Jed0vcela/easy-linear-power-supply/easy-linear-power-supply SMD/EAGLE files/linear supply3_smd.brd

## EAGLE design easy-linear-power-supply SMD/EAGLE files/linear supply3_smd.brd (2024-04-13)

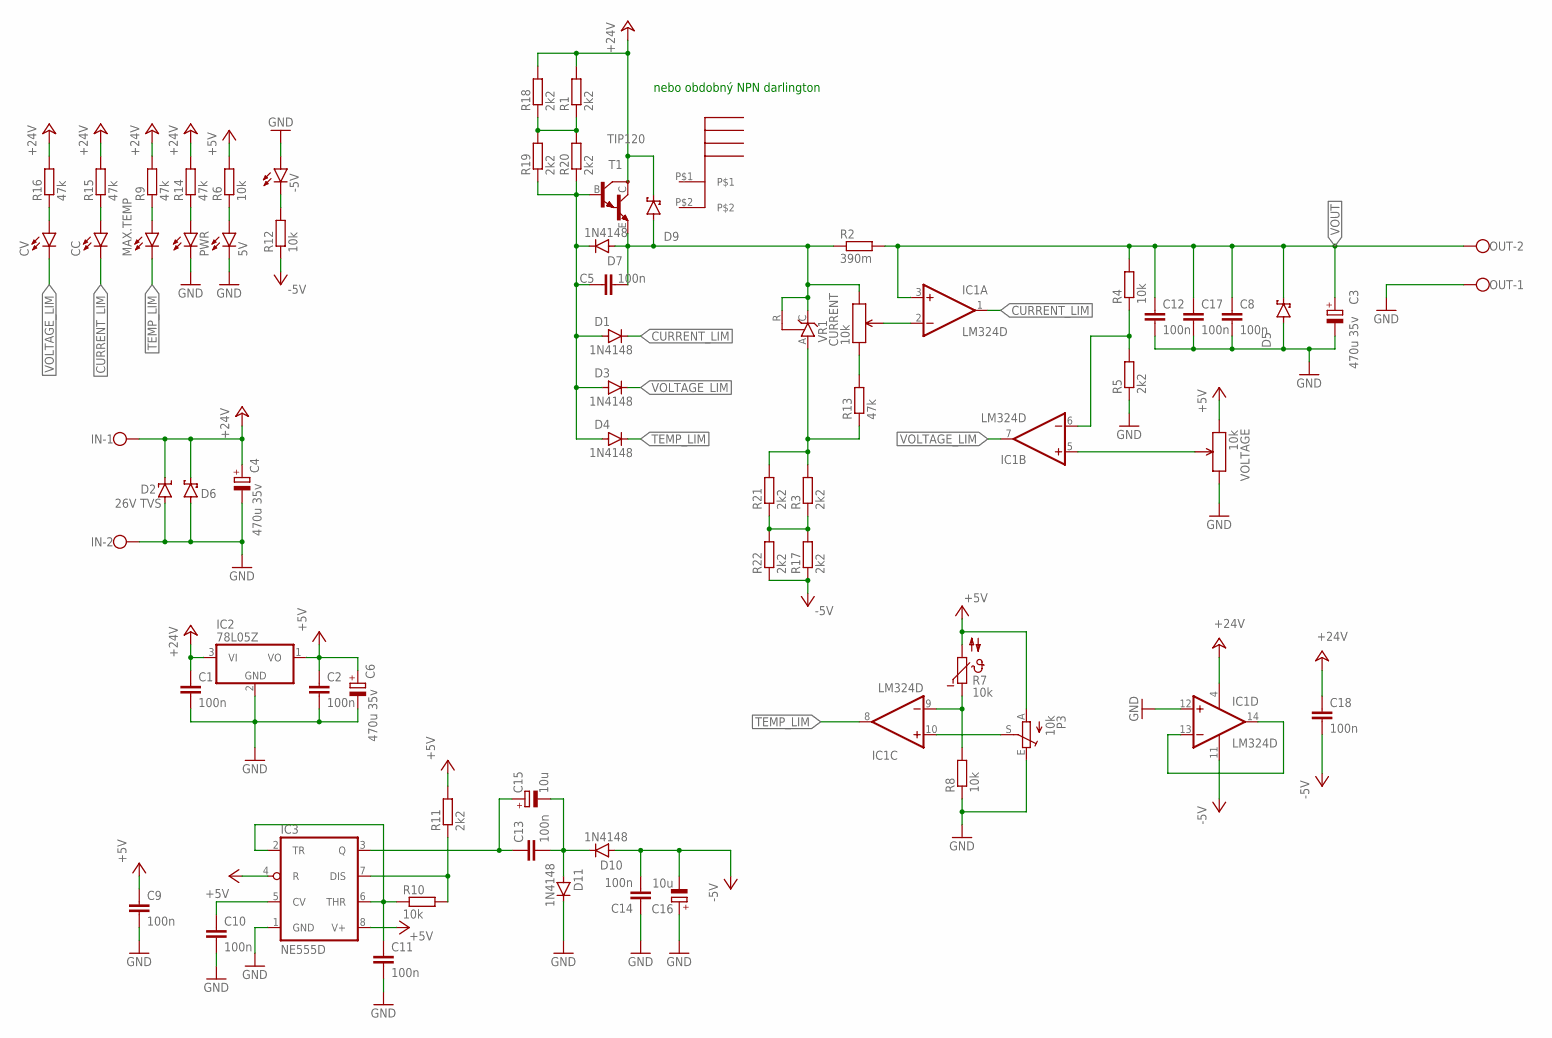
[picture p3: schematic linear supply3_smd.sch]

Parts:
5V: LEDCHIP-LED0805; CHIP-LED0805
-5V: LEDCHIP-LED0805; CHIP-LED0805
C1, C2, C5, C9, C10, C11, C13, C14, C18: 100n; C0805
C3, C4, C6: 470u 35v; E5-10,5
C8: 100n; C050-050X075
C12, C17: 100n; C1206
C15, C16: 10u; E2,5-6
CC: LEDCHIP-LED0805; CHIP-LED0805
CURRENT: 10k; THRU_PCW_POT
CV: LEDCHIP-LED0805; CHIP-LED0805
D1, D3, D4, D7, D10, D11: 1N4148; SOD80C
D2: 26V TVS; SMBJ
D5, D6, D9: SCHOTTKY-DIODESMC; SMC
IC1: LM324D; SO14
IC2: 78L05Z; TO92
IC3: NE555D; SO08
IN: W237-102
MAX.TEMP: LEDCHIP-LED0805; CHIP-LED0805
OUT: W237-102
P3: 10k; CA6V
PWR: LEDCHIP-LED0805; CHIP-LED0805
R1, R3, R5, R11, R17, R18, R19, R20, R21, R22: 2k2; R0805
R2: 390m; 0411/12
R4, R6, R8, R10, R12: 10k; R0805
R7: 10k; P642
R9, R13, R14, R15, R16: 47k; R0805
T1: TIP120; SOT93
U$1: RAD-DY-KY/3; RAD-DY-KY/3HEATSINK
VOLTAGE: 10k; THRU_PCW_POT
VR1: TL431CLP; TO92-CLP

Connections:
+5V: C2.1, C6.+, C9.1, IC2.1 (VO), IC3.4 (R), IC3.8 (V+), P3.A, R6.2, R7.2, R11.2, VOLTAGE.P$1 (1)
+24V: C1.1, C4.+, C18.1, D2.C, D6.C, D9.C, IC1.4 (V+), IC2.3 (VI), IN.1, R1.2, R9.2, R14.2, R15.2, R16.2, R18.2, T1.C
-5V: C14.2, C16.-, C18.2, D10.A, IC1.11 (V-), R12.1, R17.1, R22.1
CURRENT_LIM: CC.C, D1.C, IC1.1 (OUT)
GND: 5V.C, -5V.A, C1.2, C2.2, C3.-, C4.-, C6.-, C8.2, C9.2, C10.2, C11.2, C12.2, C14.1, C16.+, C17.2, D2.A, D5.A, D6.A, D11.C, IC1.12 (+IN), IC2.2 (GND), IC3.1 (GND), IN.2, OUT.1, P3.E, PWR.C, R5.1, R8.1, VOLTAGE.P$3 (3)
MAX: R3.2, R13.1, R21.2, VR1.A
MIN: C5.2, CURRENT.P$3 (3), D7.A, D9.A, R2.1, T1.E, VR1.C, VR1.R
unnamed: C5.1, D1.A, D3.A, D4.A, D7.C, R19.1, R20.1, T1.B
unnamed: PWR.A, R14.1
unnamed: C11.1, IC3.2 (TR), IC3.6 (THR), R10.1
unnamed: IC1.9 (-IN), R7.1, R8.2
unnamed: IC1.6 (-IN), R4.1, R5.2
unnamed: 5V.A, R6.1
unnamed: IC1.5 (+IN), VOLTAGE.P$2 (2)
unnamed: IC1.10 (+IN), P3.S
unnamed: CURRENT.P$2 (2), IC1.2 (-IN)
unnamed: MAX.TEMP.A, R9.1
unnamed: IC1.13 (-IN), IC1.14 (OUT)
unnamed: IC3.7 (DIS), R10.2, R11.1
unnamed: C13.1, C15.+, IC3.3 (Q)
unnamed: C10.1, IC3.5 (CV)
unnamed: C13.2, C15.-, D10.C, D11.A
unnamed: -5V.C, R12.2
unnamed: CURRENT.P$1 (1), R13.2
unnamed: CC.A, R15.1
unnamed: CV.A, R16.1
unnamed: R1.1, R18.1, R19.2, R20.2
unnamed: R3.1, R17.2, R21.1, R22.2
TEMP_LIM: D4.C, IC1.8 (OUT), MAX.TEMP.C
VOLTAGE_LIM: CV.C, D3.C, IC1.7 (OUT)
VOUT: C3.+, C8.1, C12.1, C17.1, D5.C, IC1.3 (+IN), OUT.2, R2.2, R4.2

Notes on the sheet:
nebo obdobný NPN darlington

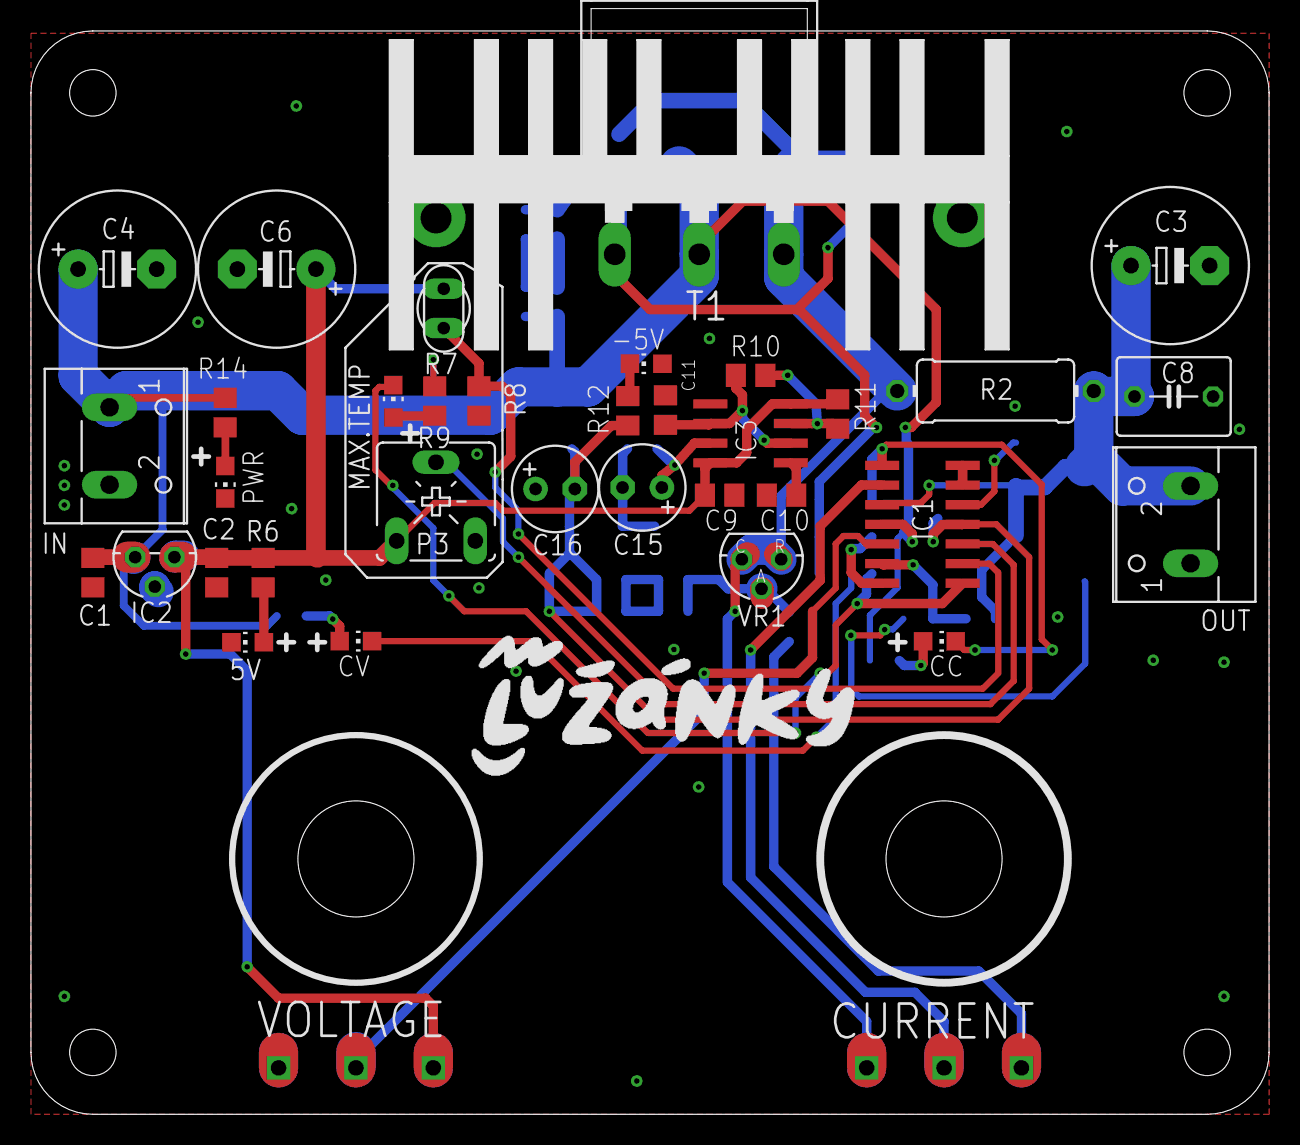
[picture p4: board linear supply3_smd.brd from above]

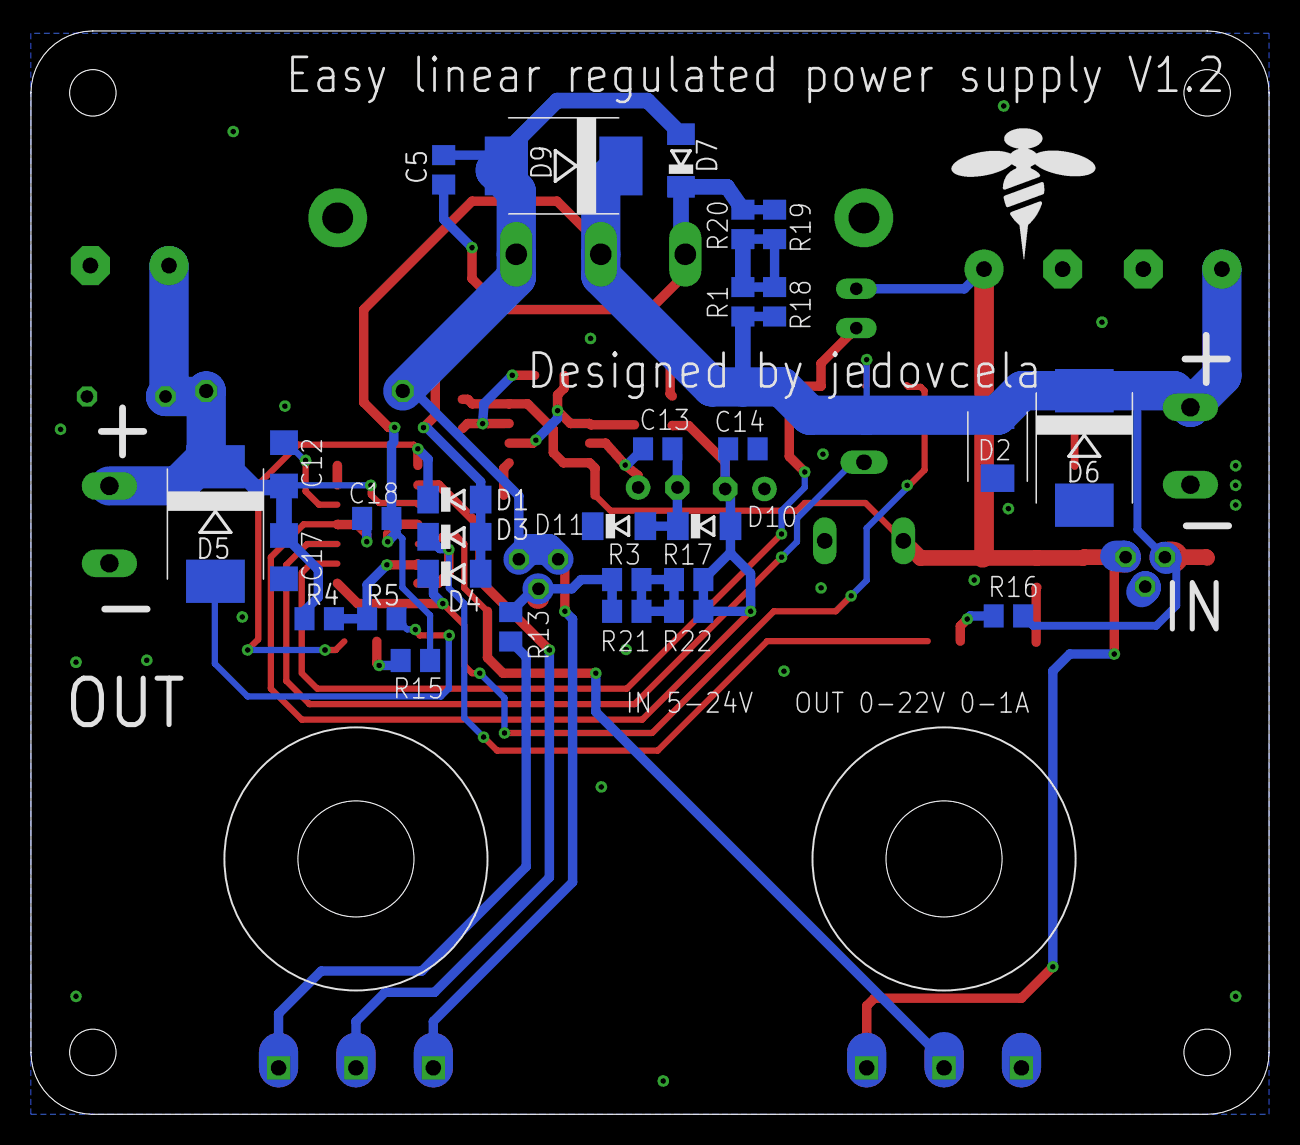
[picture p5: board linear supply3_smd.brd from below]

Board: 2 copper layers, 80.0 x 70.0 mm, 66 parts (31 on the bottom side), 31 nets.
