Jed0vcela/easy-linear-power-supply/easy-linear-power-supply THT/EAGLE file/linear supply2.brd

## EAGLE design easy-linear-power-supply THT/EAGLE file/linear supply2.brd (2024-04-13)

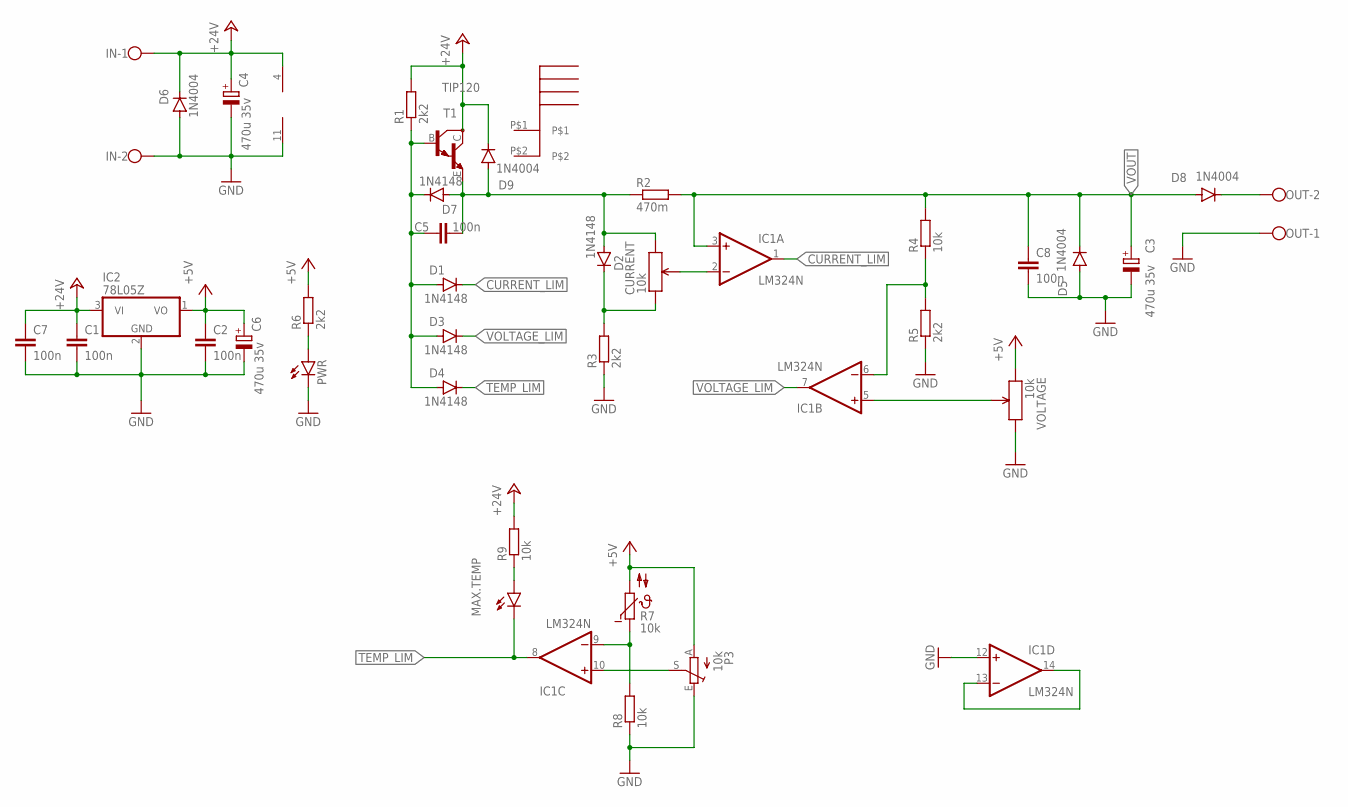
[picture p6: schematic linear supply2.sch]

Parts:
C1, C2, C5: 100n; C050-024X044
C3, C4, C6: 470u 35v; E5-10,5
C7: 100n; C1206K
C8: 100n; C050-050X075
CURRENT: 10k; THRU_PCW_POT
D1, D2, D3, D4, D7: 1N4148; DO35-7
D5, D6, D8, D9: 1N4004; DO41-10
IC1: LM324N; DIL14
IC2: 78L05Z; TO92
IN: W237-102
MAX.TEMP: LED3MM
OUT: W237-102
P3: 10k; CA6V
PWR: LED3MM
R1, R3, R5, R6: 2k2; 0207/10
R2: 470m; 0411/12
R4, R8, R9: 10k; 0207/10
R7: 10k; P642
T1: TIP120; SOT93
U$1: RAD-DY-KY/3; RAD-DY-KY/3HEATSINK
VOLTAGE: 10k; THRU_PCW_POT

Connections:
+5V: C2.1, C6.+, IC2.1 (VO), P3.A, R6.2, R7.2, VOLTAGE.P$1 (1)
+24V: C1.1, C4.+, C7.1, D6.C, D9.C, IC1.4 (V+), IC2.3 (VI), IN.1, R1.2, R9.2, T1.C
CURRENT_LIM: D1.C, IC1.1 (OUT)
GND: C1.2, C2.2, C3.-, C4.-, C6.-, C7.2, C8.2, D5.A, D6.A, IC1.11 (V-), IC1.12 (+IN), IC2.2 (GND), IN.2, OUT.1, P3.E, PWR.K (C), R3.1, R5.1, R8.1, VOLTAGE.P$3 (3)
MAX: CURRENT.P$1 (1), D2.C, R3.2
MIN: C5.2, CURRENT.P$3 (3), D2.A, D7.A, D9.A, R2.1, T1.E
unnamed: C5.1, D1.A, D3.A, D4.A, D7.C, R1.1, T1.B
unnamed: D8.C, OUT.2
unnamed: IC1.9 (-IN), R7.1, R8.2
unnamed: IC1.6 (-IN), R4.1, R5.2
unnamed: PWR.A, R6.1
unnamed: IC1.5 (+IN), VOLTAGE.P$2 (2)
unnamed: IC1.10 (+IN), P3.S
unnamed: CURRENT.P$2 (2), IC1.2 (-IN)
unnamed: MAX.TEMP.A, R9.1
unnamed: IC1.13 (-IN), IC1.14 (OUT)
TEMP_LIM: D4.C, IC1.8 (OUT), MAX.TEMP.K (C)
VOLTAGE_LIM: D3.C, IC1.7 (OUT)
VOUT: C3.+, C8.1, D5.C, D8.A, IC1.3 (+IN), R2.2, R4.2

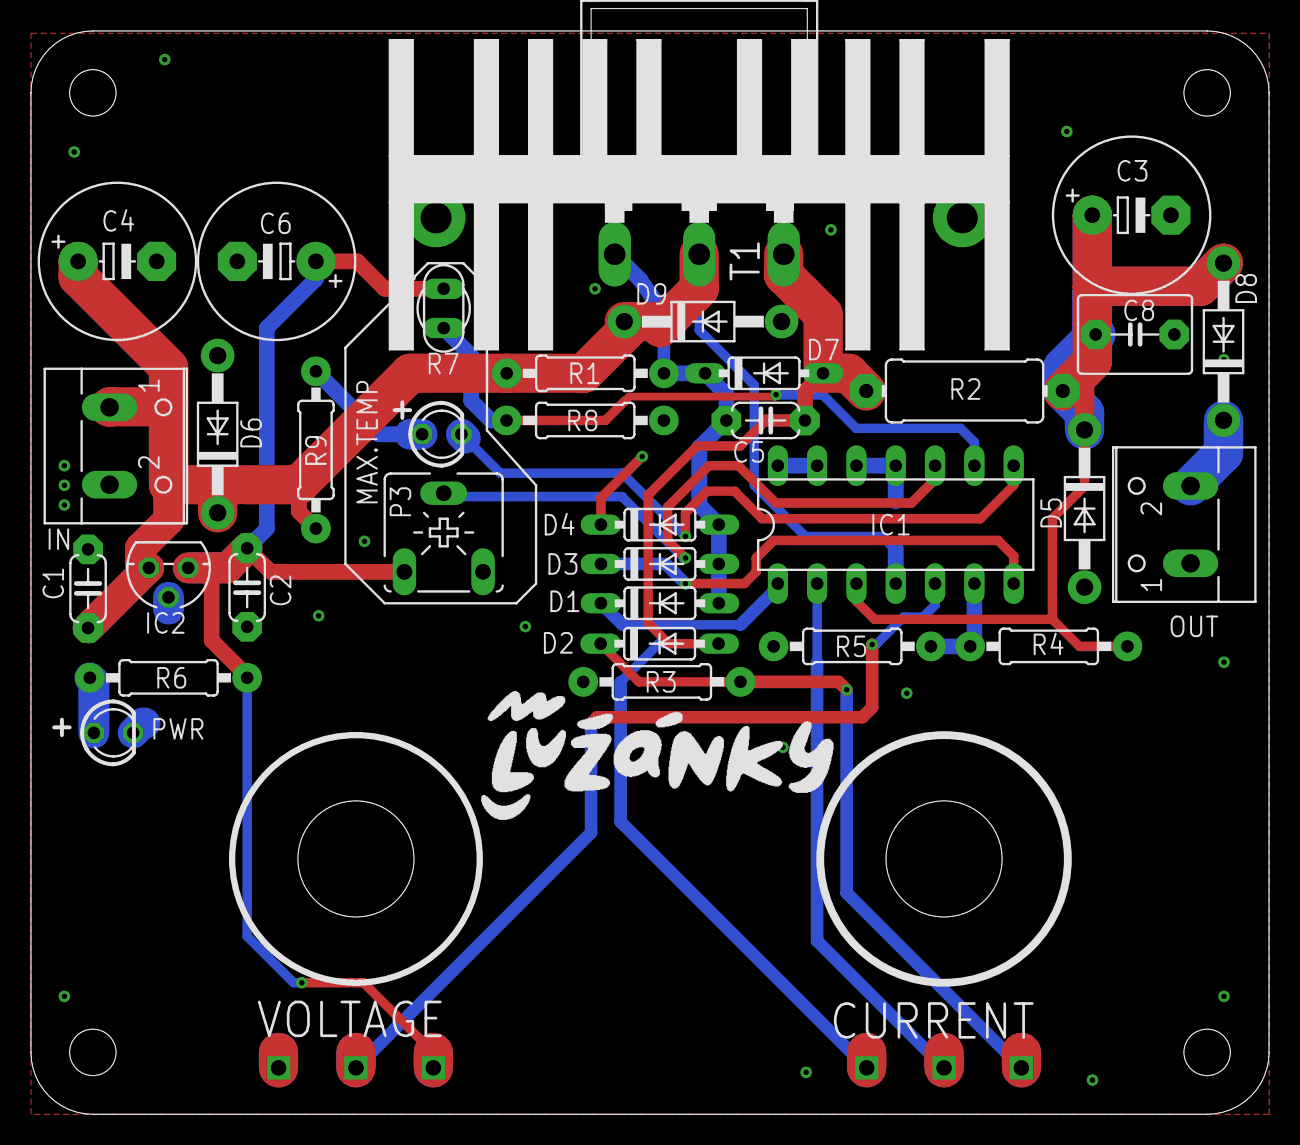
[picture p7: board linear supply2.brd from above]

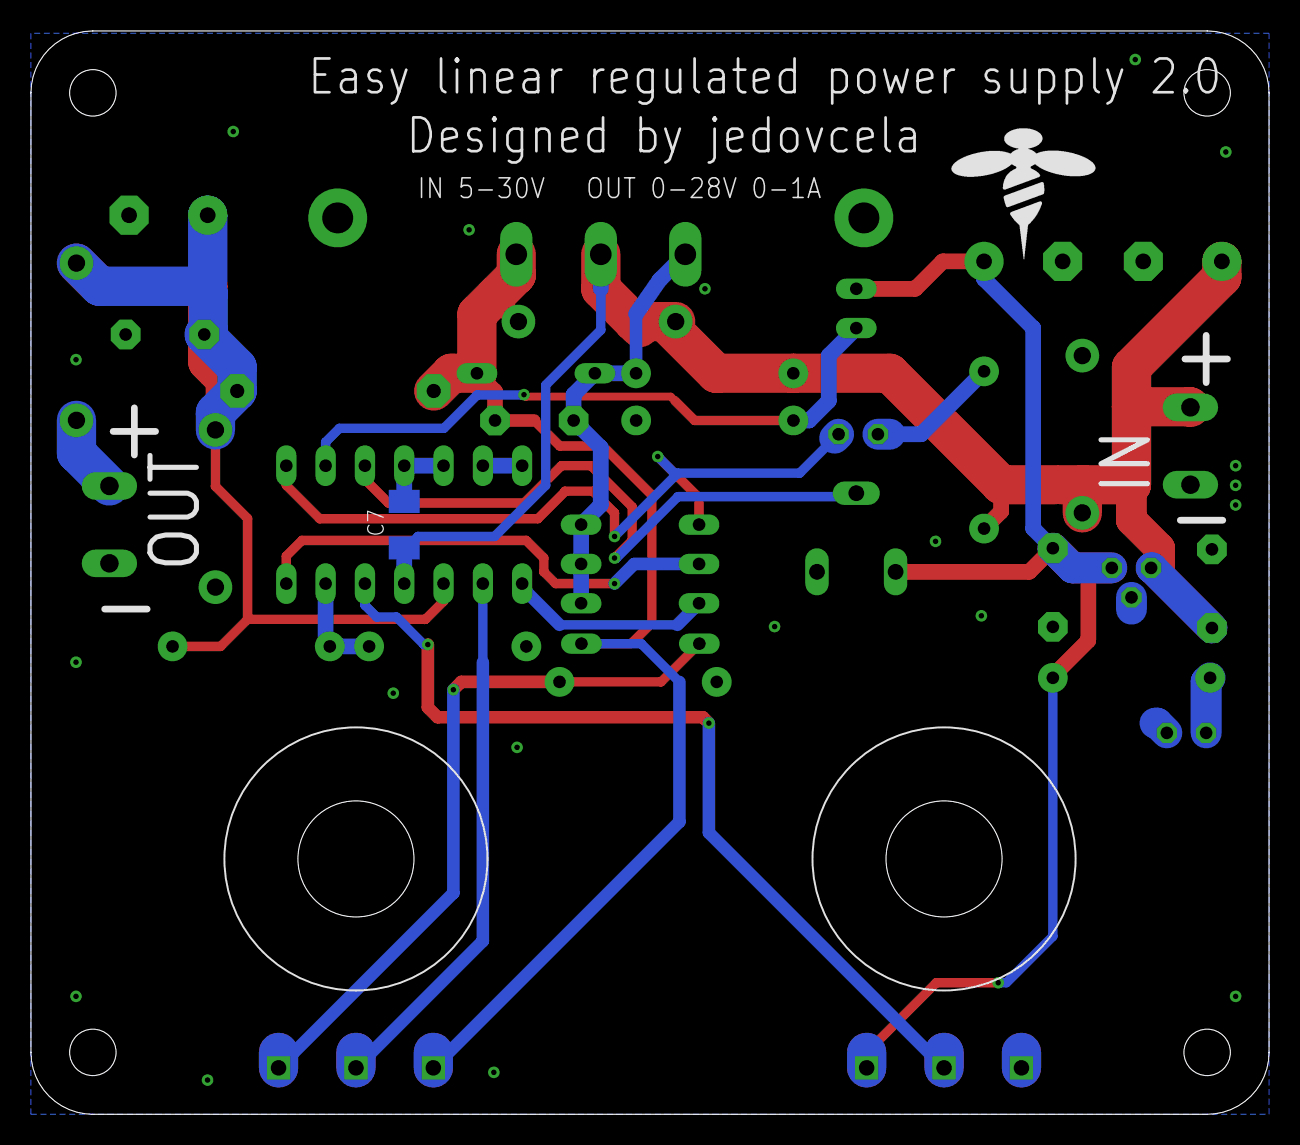
[picture p8: board linear supply2.brd from below]

Board: 2 copper layers, 80.0 x 70.0 mm, 37 parts (3 on the bottom side), 19 nets.
